nucatus/cesar/cad/cesar-3-Top plate.dxf

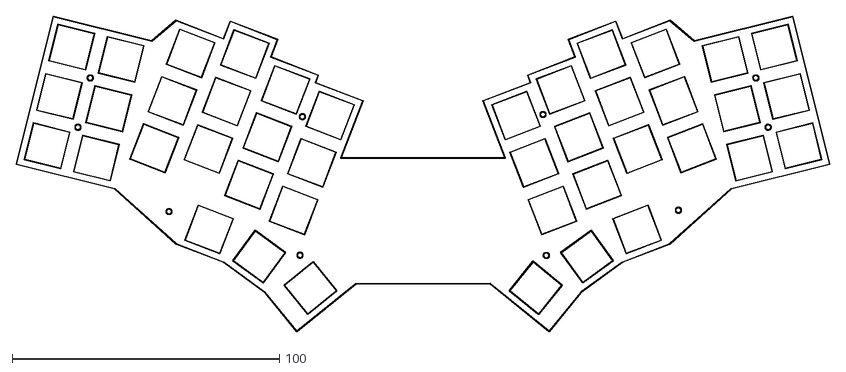
[picture p6: CAD file, 2024-01-14]
cad/cesar-3-Top plate.dxf
304.3 x 118.0
