nucatus/cesar/cesar-3-Bottom plate.dxf

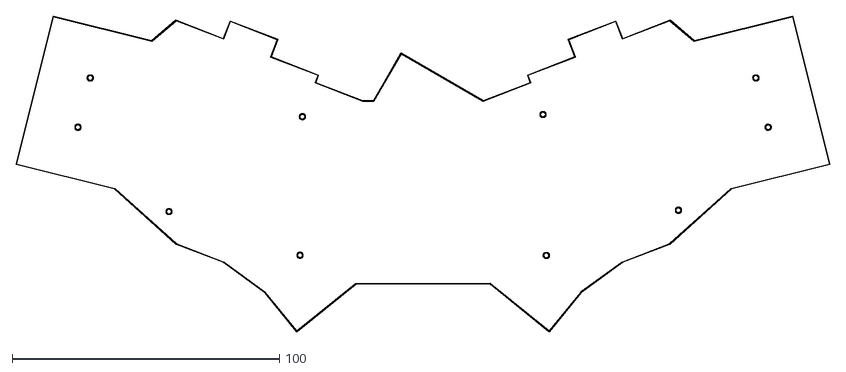
[picture p7: CAD file, 2024-01-14]
cesar-3-Bottom plate.dxf
304.3 x 118.0
