nucatus/cesar/(commit log)

2023-12-28 before ratation
    [cesar-3.kicad_pcb, cesar-3.kicad_sch]
2023-12-28 after rotarion
    [cesar-3.kicad_pcb]
2023-12-28 before rotation
    [cesar-3.kicad_pcb]
2023-12-28 after rotation
    [cesar-3.kicad_pcb]
2023-12-28 valid after rotation
    [cesar-3.kicad_pcb]
2023-12-28 routing complete
    [cesar-3.kicad_pcb]
2024-01-14 Production v0.1 PCB and plate dxf files
    The v0.1 prototype and the dxf files corresponding to the bottom and top
    plates.
    [cesar-3-Bottom plate.dxf, cesar-3-Top plate.dxf, cesar-3.kicad_pcb, cesar-3.kicad_sch]
2024-02-19 Add README with photos, PCB, schematic, plate and keymap images
    Move the plate DXFs into cad/ and the KiCad project into pcb/.
